SeanWei0312/ECG_Acquisition_IC/resources/Analog_Automation_gLayout/README.md

# gLayout Track Resources

- [Brief Overview of the gLayout](./files/Glayout_Overview.pdf)
- 🤖 [GitHub Repo](https://github.com/ReaLLMASIC/gLayout)
- :books: [gLayout Tutorials](https://github.com/ReaLLMASIC/gLayout/tree/main/tutorial)
  - [Flipped Voltage Follower (FVF)](https://github.com/ReaLLMASIC/gLayout/blob/main/tutorial/glayout_tutorial_FVF_part1.ipynb)
  - [Operational Transconductance Amplifier (OTA)]()
<!--
- :pushpin: Design Challenge
  - [Detailed Requirements](./Challenge.md)
  - [Kickoff Slides](https://docs.google.com/presentation/d/11iUuCnZQZhC-76pMEIqsWOjoYRWxP6tA/edit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)
  -->
- 🦾 [Contribution Guidelines]
  - [Fork the gLayout Repo]() 
  - [Contribute]()
  - [Create Merge Request]()

## gLayout

### A PDK-agnostic layout automation framework for analog circuit design.

gLayout is a powerful layout automation tool that generates DRC-clean circuit layouts for any technology implementing the gLayout framework. It is implemented as an easy-to-install Python package with all dependencies available on PyPI.

Key features:

- PDK-agnostic layout generation
  - Generic layer mapping
  - Technology-independent design rules
  - Support for multiple PDKs (sky130, gf180)
  - DRC-clean layout generation
- Basic Cell Generators
  - Via stack generation
  - Transistor generation (NMOS/PMOS)
  - Guard ring generation
  - And more...
- Natural language processing for circuit design
  - Convert natural language descriptions to layouts
  - Support for standard components
  - Custom component definitions
- Integration with Klayout for visualization and verification

## Citation

If you use gLayout in your research, please cite our papers:

```bibtex
@article{hammoud2024human,
  title={Human Language to Analog Layout Using gLayout Layout Automation Framework},
  author={Hammoud, A. and Goyal, C. and Pathen, S. and Dai, A. and Li, A. and Kielian, G. and Saligane, M.},
  journal={Accepted at MLCAD},
  year={2024}
}

@article{hammoud2024reinforcement,
  title={Reinforcement Learning-Enhanced Cloud-Based Open Source Analog Circuit Generator for Standard and Cryogenic Temperatures in 130-nm and 180-nm OpenPDKs},
  author={Hammoud, A. and Li, A. and Tripathi, A. and Tian, W. and Khandeparkar, H. and Wans, R. and Kielian, G. and Murmann, B. and Sylvester, D. and Saligane, M.},
  journal={Accepted at ICCAD},
  year={2024}
}
```
