SeanWei0312/ECG_Acquisition_IC/resources/C_MOSbius_playground_for_chips/cosimulation/README.md

# Cosimulation tutorial for Mixed-Signal simulations

This tutorial presents different views of a digital cell for running a co-simulation with an analog cell using gf180mcuD technology.

The goal is to perform a co-simulation between a 4-bit counter and the Verilog, Schematic, and PEX views with a current mirror that includes gf180mcu transistors. The current mirror is a schematic view.

The block diagram of the co-simulation system is presented below.

<p align="center">
   
</p>  

## Compiling and validating the Verilog code.

All the material associated with this part of the flow is in the [`verilog_verification/`](verilog_verification/) folder.

The command used for compiling is: **iverilog -o counter_tb counter.v counter_tb.v**

The command used for running the simulation is: **./counter_tb**

Finall, for checking the results, use the following command: **gtkwave counter_tb.vcd**

## Verilog view

Follows the block diagram of the circuit that instantiates a Verilog view into a symbol and the schematic of a current mirror.

<p align="center">
   
</p> 
 
When associating the Verilog code  to a symbol in Xschem, and after copiling the code for running the simulation with gf180mcu transistors, an error appears because the ngspice was compiled within the IIC-OSIC container for Chipathon. The two libraries that bridge the gap between ngspice and Icarus Verilog (ivlng.so and ivlng.vpi, both in /foss/tools/ngspice/lib/ngspice/) have all their symbols marked as local and should be as global.

<p align="center">
   
</p> 

We are working to solve this issue in the Docker container. We will keep you posted when this issue will be solved.

> 🚧 \*\*Under Construction\*\*

## Schematic view

All the material associated with this part of the flow is in the [`schematic_view/`](schematic_view/) folder.

First of all, it is necessary to run the RTL-to-GDS flow with Librelane, all the files are in the [`schematic_view/Librelane/`](schematic_view/) folder.

The command for running the Librelane Flow is: **librelane --pdk gf180mcuD config.json**

Once the flow ends, you can check all the files with all the reports associated with the different steps in the runs folder.

<p align="center">
   
</p> 

For opening the final layout, use the following command in the final/klayout_gds/ folder: **klayout -e counter.gds**

<p align="center">
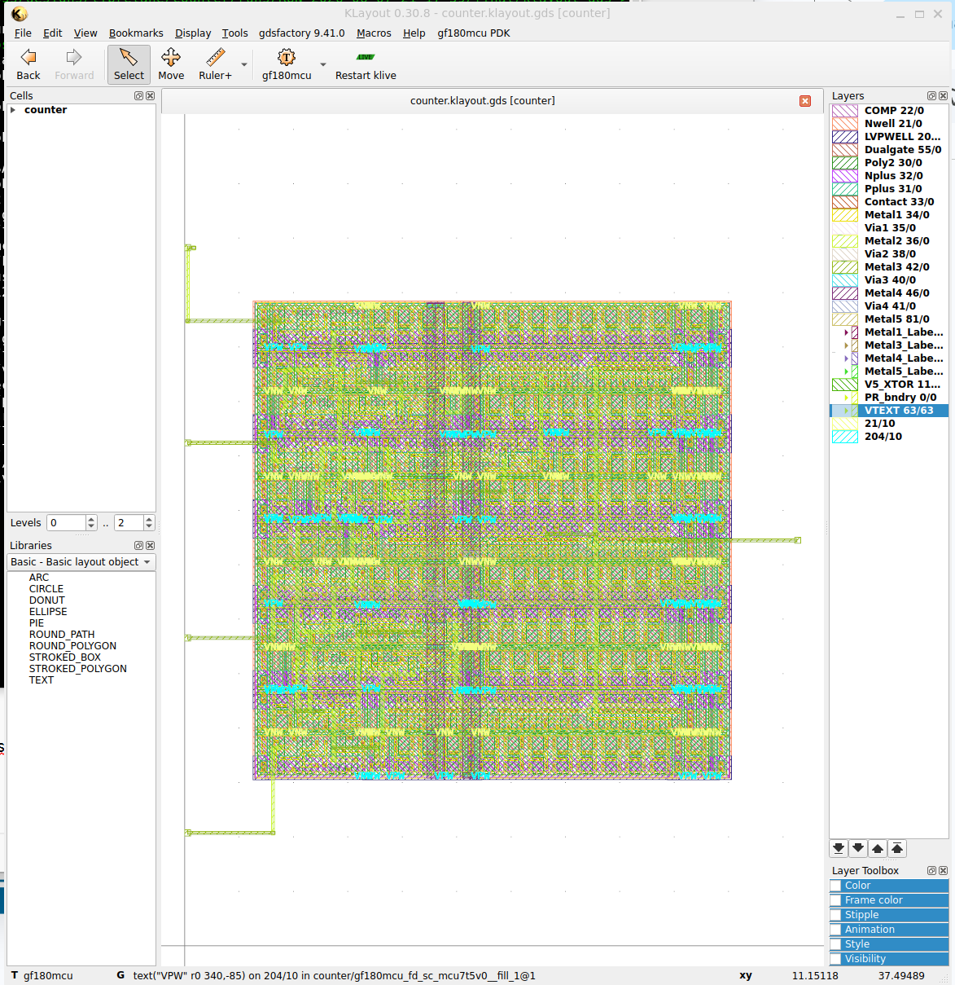
[picture p2: resources/C_MOSbius_playground_for_chips/cosimulation/img/klayout1.png]
   
</p> 

The file with the schematic netlist is in the **final/spice/** folder.

Copy the netlist file to the folder where you will run the cosimulation. In this repository, all the files are in [`schematic_view/cosimulation/`](schematic_view/) folder.

Some changes need to be made in the **counter.spice** file, as indicated in the figure below. Filler cells and decap cells need to be eliminated.

<p align="center">
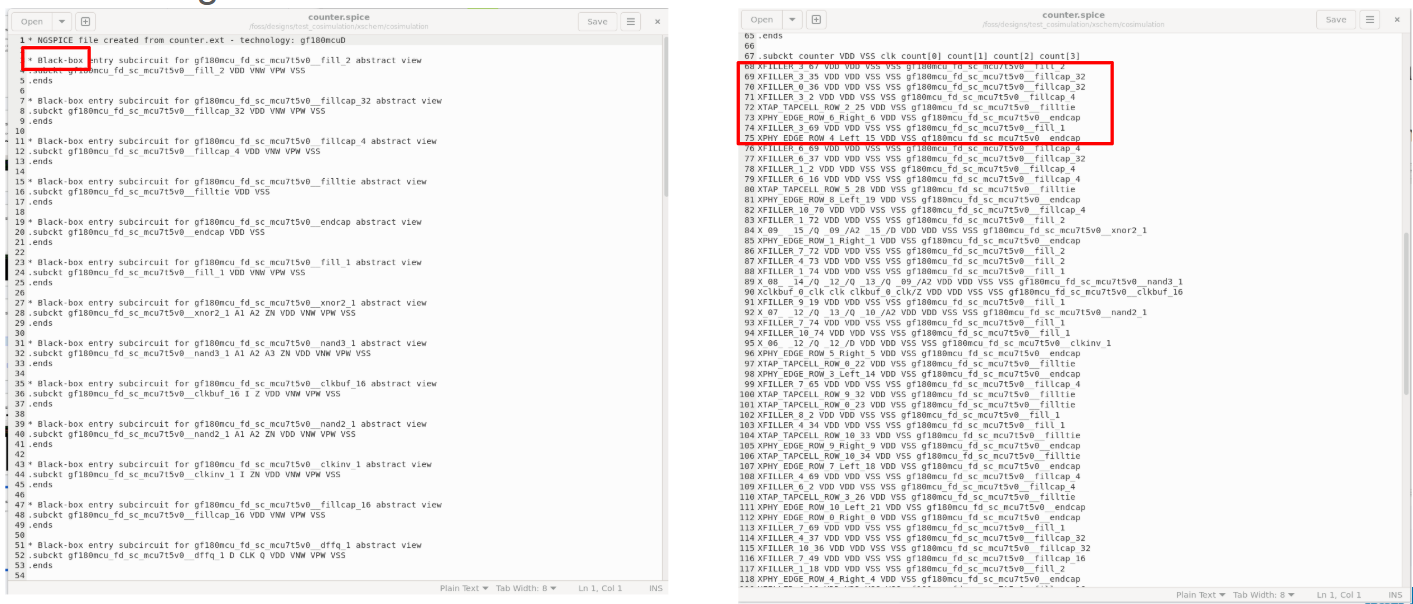
[picture p3: resources/C_MOSbius_playground_for_chips/cosimulation/img/cosimulation1.png]
   
</p> 

The sequence to run the simulations in the following:

1) In the **Simulation** tab, select the **Use 'simulation' dir in schematic dir** option.
2) Click on the **Netlist** button.
3) Click on the **Simulation** button.
4) Once the simulation ended, close the ngspice window. Then **'Ctrl' + left click button of the mouse** on the **load waves** symbol. It should take a couple of seconds loading the 
waveforms, as indicated in the figure below.

<p align="center">
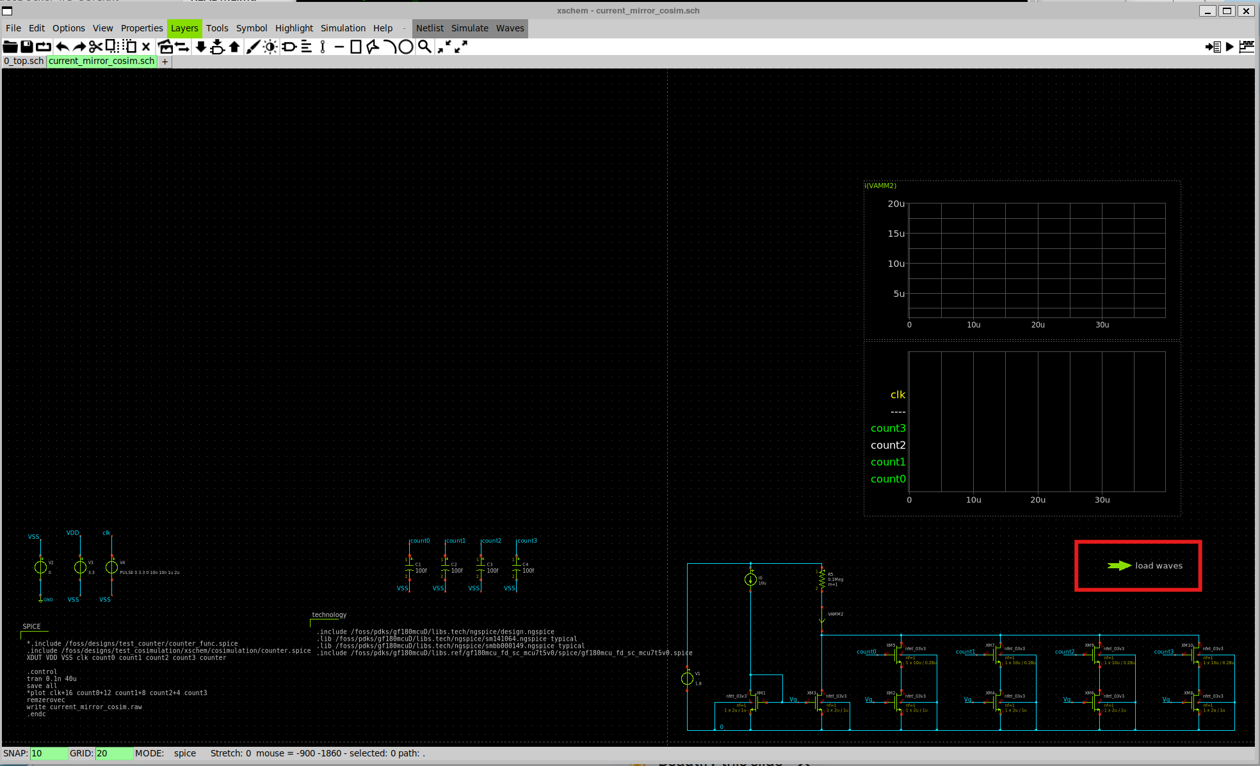
[picture p4: resources/C_MOSbius_playground_for_chips/cosimulation/img/cosimulation2.png]
   
</p> 

<p align="center">
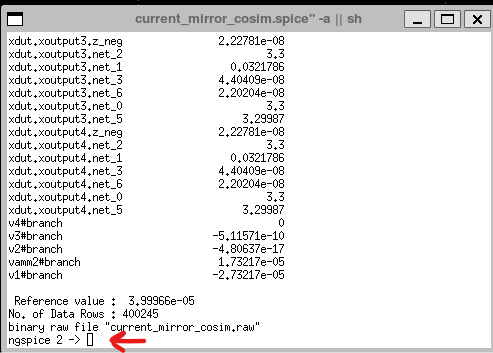
[picture p5: resources/C_MOSbius_playground_for_chips/cosimulation/img/cosimulation3.png]
   
</p> 

<p align="center">
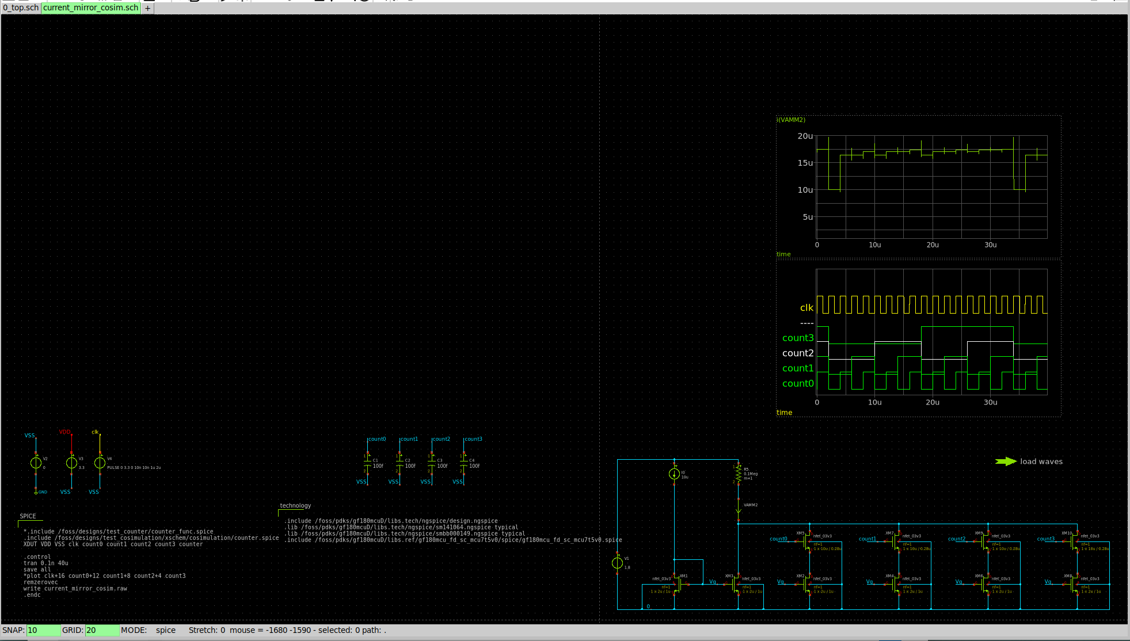
[picture p6: resources/C_MOSbius_playground_for_chips/cosimulation/img/cosimulation4.png]
   
</p> 

## PEX view
