SeanWei0312/ECG_Acquisition_IC/ECG Acquisition IC with 10-bit SAR ADC SPEC.xlsx

Spec | Data | Improve | Spec | Data | Improve | Spec | Data | Improve | Spec | Data | Improve | Spec | Data | Improve | Spec | Data | Improve
AVDD | 3.3 V | fixed | AVDD | 3.3V | fixed | AVDD | 3.3 V | fixed | AVDD | 3.3 V | fixed | AVDD | 3.3 V | fixed | Input voltage | 5 V | fixed
 |  |  | VCM | 1.65 V | fixed | VCM | 1.65 V | fixed | VCM | 1.65 V | fixed | DVDD | 3.3 V | fixed | Output voltage | 3.3 V | fixed
 |  |  | CMRR target | 90 dB | higher | HPF cutoff | 0.01 Hz | fixed | Gain control | 2 bit | higher | VCM | 1.65 V | fixed | AVDD | 3.3 V | fixed
 |  |  | Total gain | 90 V/V (39.08 dB) | fixed | LPF cutoff | 150 Hz | fixed | Gain setting 1 | 4 V/V | fixed | VREFP |  | fixed | DVDD | 3.3 V | fixed
 |  |  | 1st-stage gain | 10 V/V | fixed | Passband | 0.01–150 Hz | fixed | Gain setting 2 | 8 V/V | fixed | VREFN |  | fixed | Dropout | <300 mV | lower
 |  |  | 2nd-stage gain | 9 V/V | fixed | Stopband attenuation | 60 dB | higher | Gain setting 3 | 12 V/V | fixed | Resolution | 10 bit | fixed | PSRR @ 50/60 Hz | >60 dB | higher
 |  |  | OTA DC gain | 80 dB | higher |  |  |  | Gain setting 4 | 16 V/V | fixed | Sample rate | 10 kS/s | fixed
 |  |  | Single-ended OTA PM | 60° | higher |  |  |  | Total gain min | 360 V/V | fixed | Work clock | 320 kHz | fixed
 |  |  | Fully differential OTA PM | 60° | higher |  |  |  | Total gain max | 1440 V/V | fixed | ENOB |  | higher
 |  |  | Single-ended OTA bias | 40 µA | lower |  |  |  |  |  |  | INL |  | lower
 |  |  | Fully differential OTA bias | 50 µA | lower |  |  |  |  |  |  | DNL |  | lower
 |  |  | CMFB error amp bias | 50 µA | lower
