SeanWei0312/ECG_Acquisition_IC/schedule/README.md

# SSCS Chipathon 2026 Schedule

This document outlines the official schedule for the SSCS Chipathon 2026 event.
<br>All dates and activities are subject to confirmation.
<br>This is the 8am PT [weekly zoom meeting link](https://us06web.zoom.us/j/87694732928?pwd=gjUePaAEKDJB2G3f2d4iPIqyYe0qBx.1).
<br>Please follow the Chipathon Discord Server [Join_server](https://discord.gg/tvZcQzvt7q) for up-to-date information and **announcements**. 
<br>All participants should complete a report by Wednesday of **each** week.

## 🗓️ Detailed Timeline

### Phase 1: Setup and Introduction
| Week | Date | Event | Track Details | 🔴 Recording | 📊 Slides | 📄 Report |
|---|---|---|---|:---:|:---:|:---:|
| Week 19 | May 8 | **Kick-off Meeting** 🎓 | • Explain the different phases of Chipathon (Mehdi Saligane) | [Watch](https://us06web.zoom.us/rec/share/xhAeTdAPaU77YRsU4t_Q-E41hRicV-ab5xPvtx_s73yeb8BakzFSihVeXmSdaLQF.pho0MkNOSw_0mVMb) | [View](https://docs.google.com/presentation/d/e/2PACX-1vS0FR0zXk5OT03u0vTPz__WF2TcbxiVppoEyPhbsLTgC3EPxX-VpvyrcpCeCY_emw/pub) | closed |
| Week 20 | May 15 | **Tool Installation** 🎓 | • Tutorial on xschem in GF from schematic to Layout & Spice Simulation (Saroj) <br> • Librelane Tutorial (Mauricio) <br> • DRC/LVS (Mitch) | [Watch](https://us06web.zoom.us/rec/share/7zD5YMcYuP_7zsn03mudSRr1iZ_iZvFGw_r3zQALDaS0kD1FwE4AAih6qV63WzpB.rxw93Cc6FIBtpyRp) | [View](https://docs.google.com/presentation/d/e/2PACX-1vSFLC4CtHCYh4NrQxUPHT01zM8Mj39ZOmFqZuFMlWBCxX44cPWaUJRWhY8hl38a_Q/pub) | closed |
| Week 21 | May 22 | **Tutorial Sessions** 🎓 | • MOSbius Overview (Andrew Chon)<br>• gLayout [Tutorial 1 FVF](https://github.com/ReaLLMASIC/gLayout/blob/main/tutorial/glayout_tutorial_FVF_part1.ipynb) (Luighi) | [Watch](https://us06web.zoom.us/rec/share/i6gGItWpTriycR9Vz1Rcwi5HxPswXAdAXv9iy_UUyQIKtjeq1cgjDXfQwc3FVlXj.y_eDORm6bc2WuAs-) | [View](https://docs.google.com/presentation/d/e/2PACX-1vSMgWGc4wd2y3oCXPovcalyahoOMKKFyx0ZqtsaBfOtss39HV3pLOSkca_K4jcmtg/pub) | closed |
| Week 22 | May 29 | **Tutorial Sessions** 🎓 | • Charlib (James)<br>• Full custom analog design flow (Vipul)<br> • ORFS Tutorial (Gaurav) <br>• gLayout [Tutorial 2 OTA]() (Anhang) | [Watch](https://us06web.zoom.us/rec/share/MLNBCb7vB8ggzrkPwc0yAslUJFi819PqMK6GzwiTdWhMRykd2PMECP5OVaj9fJtg.FKPz8puBRcpvN9k1) | [View](https://docs.google.com/presentation/d/e/2PACX-1vQTP6VWPEWemqOwfaWyAoGDvfKKkSd3Na3WMATTWCTAIPIPWx0YFB2lkzolOIVV8w/pub) | closed |

### Phase 2: Team Formation and Project Planning
| Week | Date | Event | Details | 🔴 Recording | 📊 Slides | 📄 Report |
|---|---|---|---|:---:|:---:|:---:|
| Week 23 | June 5 | **Team Formation Deadline**| • Chip design with AI/LLM (Mehdi) <br>• Hands-on Tutorial on MOSbius (Juan)| [Watch]( https://us06web.zoom.us/rec/share/lz8rKOhmYU-1TsQuje8IZh32oWiNp8pjVdyQ4QdtBKiGaN21z6OqeIRHgq0hYxV8.zMbz-0kW_5zsKOk8) | [View](https://docs.google.com/presentation/d/e/2PACX-1vQI_AdDKBr6G66_IMallotI_idrNMwKabdypLI7G8iEzwwMeTTeQIN3yLcrxRuJxQ/pub) | closed |
| Week 24 | June 12 | **Project Proposal Review** 👥 | - | [Watch A01-A35](https://drive.google.com/file/d/1L1Z3aQcKbWLOrGrg6Hj4yo3hvyqHSkSH/view?usp=drive_link) <br>[Watch A36-A70](https://drive.google.com/file/d/1zNI8uM8IrhVsJ0CvSOXPGysJ70YsLTbz/view?usp=drive_link) <br> [Watch B01-B30](https://drive.google.com/file/d/186RtQrj5eBq5YQaNelR__m42KvpKolv7/view?usp=drive_link) <br> [Watch C01-D16](https://drive.google.com/file/d/1WcvnuNNZa5OvVjBBpA2cFpxIVmz5NF8p/view?usp=drive_link)| [View A01-A35](https://docs.google.com/presentation/d/1YiHz-10-ayeriHM-xqGJkT-SbB14Z78Zl8ZGlZeix68/edit?usp=sharing)  <br>[View A36-A70](https://docs.google.com/presentation/d/1hOIqOPzlGIcLJ2AFiHNvrpxC8wyUOxMAJF15Aqmjsis/edit?usp=sharing) <br> [View B01-B30](https://docs.google.com/presentation/d/1q4hdv7IWDyOom2BOauEokjyfa9oZNoGCGBChGqaYRIs/edit?usp=sharing) <br> [View C01-D16](https://docs.google.com/presentation/d/1fg-tLoPCH4SCN_3tkq7wYo87EJUDZR3OUUjlz6IXLH8/edit?usp=sharing)| closed |
| Week 25 | June 19 | **Advanced Topics** 🎓 | • Systematic Design of Analog CMOS Circuits (Boris) | [Watch](https://us06web.zoom.us/rec/share/3vk6f6Bt4MRCwtoFo-XEr-KmHi765R8c8R6uieeFrG9smnGP3wtC_eQlbBFLzGra.8AWW7h7pANInL2vD) | [View](https://docs.google.com/presentation/d/e/2PACX-1vQskh77zL1A6RuCtjrjYBFjEMV9KKKAnJLeW1QzCBsPwpewTReR5-Y35LPDksaUCA/pub)| closed |
| Week 26 | June 26 | **Analog Design Ideas** 🎓 | • Overview of MEMS sensors (Camilo) <br>• Introduction to CACE (Leo)| [Watch](https://us06web.zoom.us/rec/share/F5SoZ1tjJ3ukiBgUIBTINPDOeT-OkPaO-5CeIl7zW6LeFi0y_aNfPbf5_4uGC8Wb.u2S9Jk62cXnbVsac) | [View](https://docs.google.com/presentation/d/e/2PACX-1vTqOtDIIBs6RNZgejP_mli8eXTi4CajlAEZ0-tehu2-FIgI78x62veDrAMgh-xYEQ/pub) | [Submit](https://forms.gle/6839F1Jppxx42yw5A) |

### Phase 3: Design and Simulation
| Week | Date | Event | Review Focus | 🔴 Recording | 📊 Slides | 📄 Report |
|---|---|---|---|:---:|:---:|:---:|
| Week 27 | July 3 | **Analog Design Ideas** 👥  | • Tutorial: Schematic Database & Simulations (Peter)<br>• Analog devices for RF applications (Sadayuki) |  |  |  |
| Week 28 | July 10 | **Simulation Review ** 👥 | All Tracks |  |  |  |
| Week 29 | July 17 | **Simulation Review ** 👥 | - |  |  |  |
|  | | **READiness Check & Go/No-go Decision** |  |  |  |  |

### Phase 4: Layout and Verification
| Week | Date | Event | Details | 🔴 Recording | 📊 Slides | 📄 Report |
|---|---|---|---|:---:|:---:|:---:|
| Week 30 | July 24 | **Layout Tutorial** 🎓 | • DRC, LVS, PEX (Mitch, Juan) <br> (tentative) |  |  |  |
| Week 31 | July 31 | **DRC Dry-run** | GDS to Channel Partner |  |  |  |  |
| Week 32 | Aug. 7 | **Integration Tutorial** 🎓 | Layout, Top level, ESD, padframe, packaging (Tim, Juan) |  |  |  |
| Week 33 | Aug. 14 | **Layout Review (blocks)** 👥 | - |  |  |  |
| Week 34 | Aug. 21 | **Layout Review (top level)** 👥 | - |  |  |  |
|  | | **DRC Dry-run GDS to Channel Partner**  | |  |  |  |
| Week 35 | Aug. 28 | **Verification** 👥 | Secondary ESD (Juan/Luighi) |  |  |  |
|  | | **Final Chip Review** 👥 | - |  |  |  |
|  | TBD | **Final Submission** | DRC-clean GDS to Channel Partner |  |  |  |  |
|  | TBD | **Post-mortem** 👥 | Project retrospective |  |  |  |

### Phase 5: Manufacturing and Testing
| Date | Event | 🔴 Recording | 📊 Slides | 📄 Report |
|---|---|:---:|:---:|:---:|
| TBD | Chips available for testing |  |  |  |  |
| TBD | Upload of Chip Test Results 👥 |  |  |  |  |

## 📋 Track Overview

The chipathon includes several parallel tracks:
- **A. Foundational building blocks**: Focused on basic analog and digital blocks.
- **B. Circuits for sensors**: Focused on circuits and systems enabling sensing, readout, and edge signal processing.
- **C. MOSbius playground for chips**: Focused on educational chips MOSbius style.
- **D. AI/LLM for circuits**: Focused on automated design flows (analog or digital) powered by AI.

## 🎯 Legend
- 🎓 **Presentations by mentors**: Technical sessions and tutorials
- 👥 **Presentations by participants**: Reviews and demonstrations
- 📼 **Recordings**: Links to session recordings (TBA = To Be Added)

## ⚠️ Important Notes

- All dates are subject to change
- Participants should complete installations and review materials before their respective sessions
- Regular attendance in tutorial sessions is highly recommended
- Teams must meet all review deadlines to proceed to the next phase
- The go/no-go decision on (TBD) is a critical milestone for proceeding with manufacturing
- All sessions will be recorded and made available after each meeting

## 📞 Support

For questions about specific issues, please contact the respective leaders:
- A. Foundational building blocks: James Stine, Saroj, Gaurav, Akhilesh Patil, Sumanth Kamineni
- B. Circuits for sensors: Camilo Velez, Vipul Sharma
- C. MOSbius playground for chips: Peter Kinget, Juan Moya Baquero, Luighi
- D. AI/LLM for circuits: Luighi, Mehdi Saligane, Saptarshi Ghosh, Gaurav, Osama Khan, Trio Adiono/Nur, Mauricio Montanares
- Tooling: Mitch, Harald, Leo, Saroj, Mehdi, Peter, Vipul, Herman, Luighi
- Integration: Juan M. Baquero
- Logistics: John, Indira, Mitch
