SeanWei0312/ECG_Acquisition_IC/Design_Files/IC Design/Schematic/AFE_BLOCKS/MIRROR/MIRROR.png

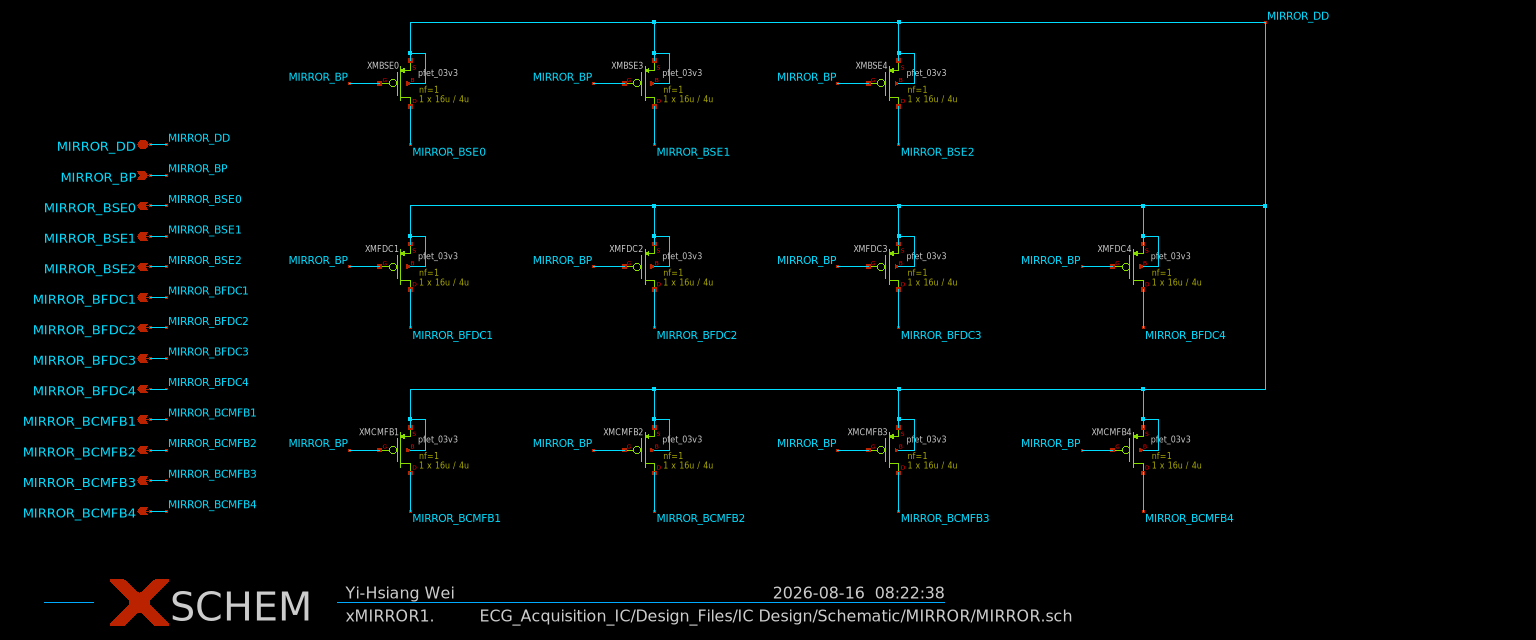
Design_Files/IC Design/Schematic/AFE_BLOCKS/MIRROR/MIRROR.png
