SeanWei0312/ECG_Acquisition_IC/Measurement_Results/IC_Simulation/AFE_BLOCKS/BIAS/BIAS_startup_summary.csv

Parameter | Value | Unit | Process | Condition | Temp_C | VDD_V | Total
Worst startup time | 1180.281 | us | SS | TLVL | -40.000 | 3.000
Startup failures | 0 | count |  |  |  |  | 35
