SeanWei0312/ECG_Acquisition_IC/Measurement_Results/IC_Simulation/ANALOG_BLOCKS/FDOTA/CMFB/NOM.CMFB_summary.csv

Parameter | Unit | Value
Set conditions
AVDD | V | 3.3
Bias current | uA | 40
CLoad per output | pF | 10
Vin,diff | V | 0
VCMFB,REF | V | 1.65
Vout,cm target | V | 1.65
Operating
Total current | uA | 39.8238
Total power | mW | 0.131418
VCMFB,OUT | V | 2.4832
VCMFB,IN | V | 1.64994
VCMFB,OUT target | V | 2.4832
Open-loop
DC gain | dB | 45.1371
UGF | MHz | 967.213
PM | deg | 71.9003
Closed-loop
VCMFB,OUT err | mV | -0.00011719
VCMFB,IN err | mV | -0.0585949
Valid VCMFB,REF | V | 1.05-3.01
tsettle low | ns | 5.2
tsettle high | ns | 5.2
