SeanWei0312/ECG_Acquisition_IC/Measurement_Results/IC_Simulation/ANALOG_BLOCKS/FDOTA/Results/FULL_FDOTA_MC_Summary.csv

Parameter | Unit | Spec | Min | MeanMinus3Sigma | MeanMinusSigma | Mean | MeanPlusSigma | MeanPlus3Sigma | Max | Yield_pct
FDC bias current | uA | 40±10 | 38.7426 | 38.1954400411523 | 39.4657226803841 | 40.100864 | 40.7360053196159 | 42.0062879588477 | 41.7383 | 100
CMFB bias current | uA | 40±10 | 38.7322 | 38.2207218172121 | 39.4793056057374 | 40.1085975 | 40.7378893942627 | 41.996473182788 | 41.627 | 100
Total current | mA | ≤2.5 | 1.51992 | 1.49782080434806 | 1.57035383478269 | 1.60662035 | 1.64288686521731 | 1.71541989565194 | 1.74577 | 100
Total power | mW |  | 5.01572 | 4.94281179403299 | 5.18216883134433 | 5.30184735 | 5.42152586865567 | 5.66088290596701 | 5.76104 | NaN
Differential DC gain | dB | ≥85 | 91.1431 | 90.9713651848174 | 91.6781257282724 | 92.031506 | 92.3848862717275 | 93.0916468151826 | 93.0003 | 100
Differential UGF | MHz | ≥8 | 12.8589 | 12.6610961624769 | 13.9721143874923 | 14.6276235 | 15.2831326125077 | 16.5941508375231 | 16.8425 | 100
Differential phase margin | deg | ≥60 | 73.4026 | 72.9781425439753 | 75.7096765146584 | 77.0754435 | 78.4412104853416 | 81.1727444560247 | 80.5429 | 100
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
