SeanWei0312/ECG_Acquisition_IC/Measurement_Results/IC_Simulation/ANALOG_BLOCKS/FDOTA/Results/MM_FDOTA_MC_Summary.csv

Parameter | Unit | Spec | Min | MeanMinus3Sigma | MeanMinusSigma | Mean | MeanPlusSigma | MeanPlus3Sigma | Max | Yield_pct
FDC bias current | uA | 40±10 | 38.8722 | 38.4336959842166 | 39.5351519947389 | 40.08588 | 40.6366080052611 | 41.7380640157834 | 41.518 | 100
CMFB bias current | uA | 40±10 | 38.9268 | 38.4586851912279 | 39.5486367304093 | 40.0936125 | 40.6385882695907 | 41.728539808772 | 41.5456 | 100
Total current | mA | ≤2.5 | 1.54166 | 1.52528877524591 | 1.57761509174864 | 1.60377825 | 1.62994140825136 | 1.68226772475409 | 1.68284 | 100
Total power | mW |  | 5.08749 | 5.03345398922018 | 5.20612982974006 | 5.29246775 | 5.37880567025994 | 5.55148151077982 | 5.55336 | NaN
Differential DC gain | dB | ≥85 | 92.0457 | 92.0503053875104 | 92.0596107958368 | 92.0642635 | 92.0689162041632 | 92.0782216124896 | 92.0742 | 100
Differential UGF | MHz | ≥8 | 13.8096 | 13.6255065444044 | 14.2630621814681 | 14.58184 | 14.9006178185319 | 15.5381734555956 | 15.8248 | 100
Differential phase margin | deg | ≥60 | 76.4466 | 76.5202623512142 | 76.9214434504047 | 77.122034 | 77.3226245495953 | 77.7238056487858 | 77.6478 | 100
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
