SeanWei0312/ECG_Acquisition_IC/Measurement_Results/IC_Simulation/ANALOG_BLOCKS/FDOTA/Results/FDOTA_MC_Run_Summary.csv

Mode | RequestedRuns | ValidRuns | FailedRuns | OverallYield_pct
MM | 200 | 200 | 0 | 100
GL | 200 | 200 | 0 | 100
FULL | 200 | 200 | 0 | 100
