SeanWei0312/ECG_Acquisition_IC/Measurement_Results/IC_Simulation/ANALOG_BLOCKS/FDOTA/Results/GL_FDOTA_MC_Summary.csv

Parameter | Unit | Spec | Min | MeanMinus3Sigma | MeanMinusSigma | Mean | MeanPlusSigma | MeanPlus3Sigma | Max | Yield_pct
FDC bias current | uA | 40±10 | 39.2727 | 39.1210362629115 | 39.7919970876372 | 40.1274775 | 40.4629579123629 | 41.1339187370885 | 40.9503 | 100
CMFB bias current | uA | 40±10 | 39.2727 | 39.1210362629115 | 39.7919970876372 | 40.1274775 | 40.4629579123629 | 41.1339187370885 | 40.9503 | 100
Total current | mA | ≤2.5 | 1.54822 | 1.53464318469886 | 1.58330886156629 | 1.6076417 | 1.63197453843371 | 1.68064021530114 | 1.68094 | 100
Total power | mW |  | 5.10913 | 5.06432604194118 | 5.22492018064706 | 5.30521725 | 5.38551431935294 | 5.54610845805882 | 5.54711 | NaN
Differential DC gain | dB | ≥85 | 91.1432 | 90.972535795399 | 91.6783885984663 | 92.031315 | 92.3842414015336 | 93.090094204601 | 92.9965 | 100
Differential UGF | MHz | ≥8 | 13.0821 | 12.7801082126749 | 14.0168657375583 | 14.6352445 | 15.2536232624417 | 16.4903807873251 | 16.2653 | 100
Differential phase margin | deg | ≥60 | 73.5783 | 73.0423383789955 | 75.7334647929985 | 77.079028 | 78.4245912070015 | 81.1157176210045 | 80.6022 | 100
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
