SeanWei0312/ECG_Acquisition_IC/Measurement_Results/IC_Simulation/AFE_BLOCKS/AFE/Plots/AFE_selector_routing.png

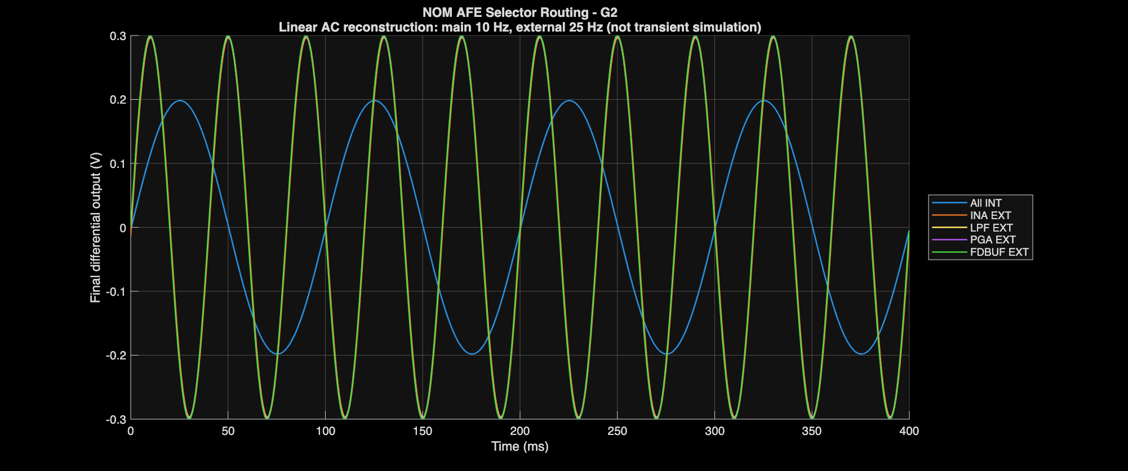
Measurement_Results/IC_Simulation/AFE_BLOCKS/AFE/Plots/AFE_selector_routing.png
