SeanWei0312/ECG_Acquisition_IC/Measurement_Results/IC_Simulation/ANALOG_BLOCKS/FDOTA/CMFB/Plots/cl_dc.png

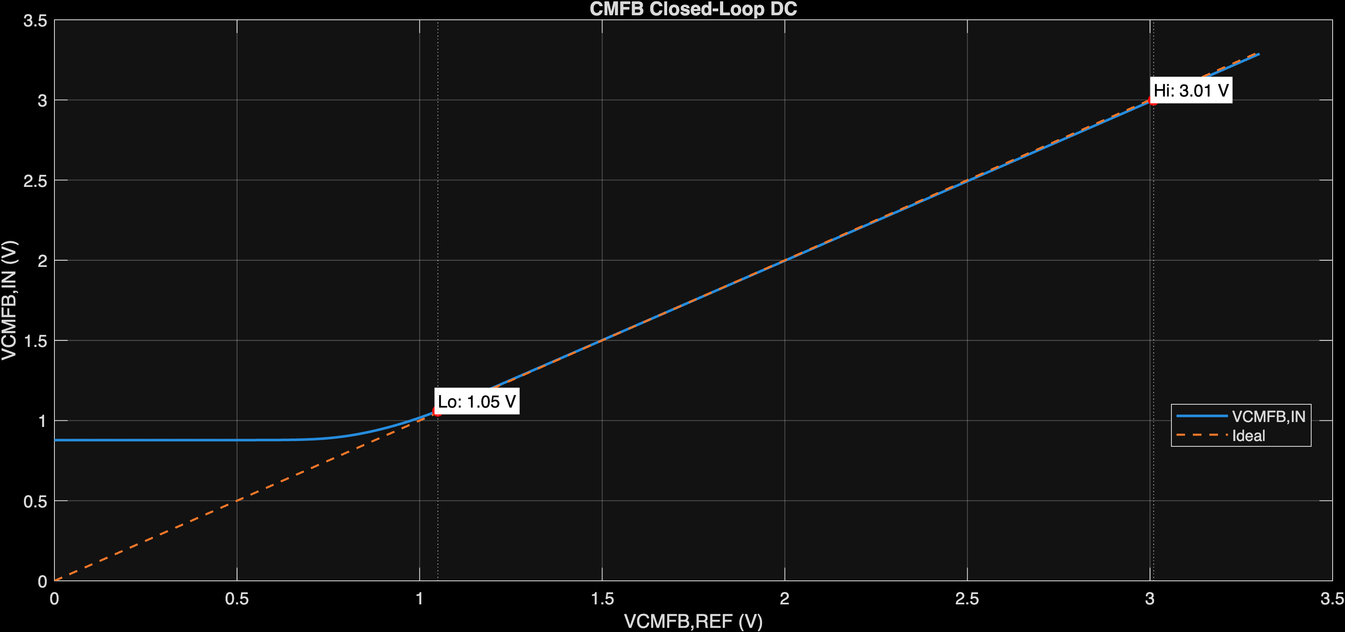
Measurement_Results/IC_Simulation/ANALOG_BLOCKS/FDOTA/CMFB/Plots/cl_dc.png
