SeanWei0312/ECG_Acquisition_IC/Measurement_Results/IC_Simulation/ANALOG_BLOCKS/FDOTA/CMFB/Plots/ol_ac.png

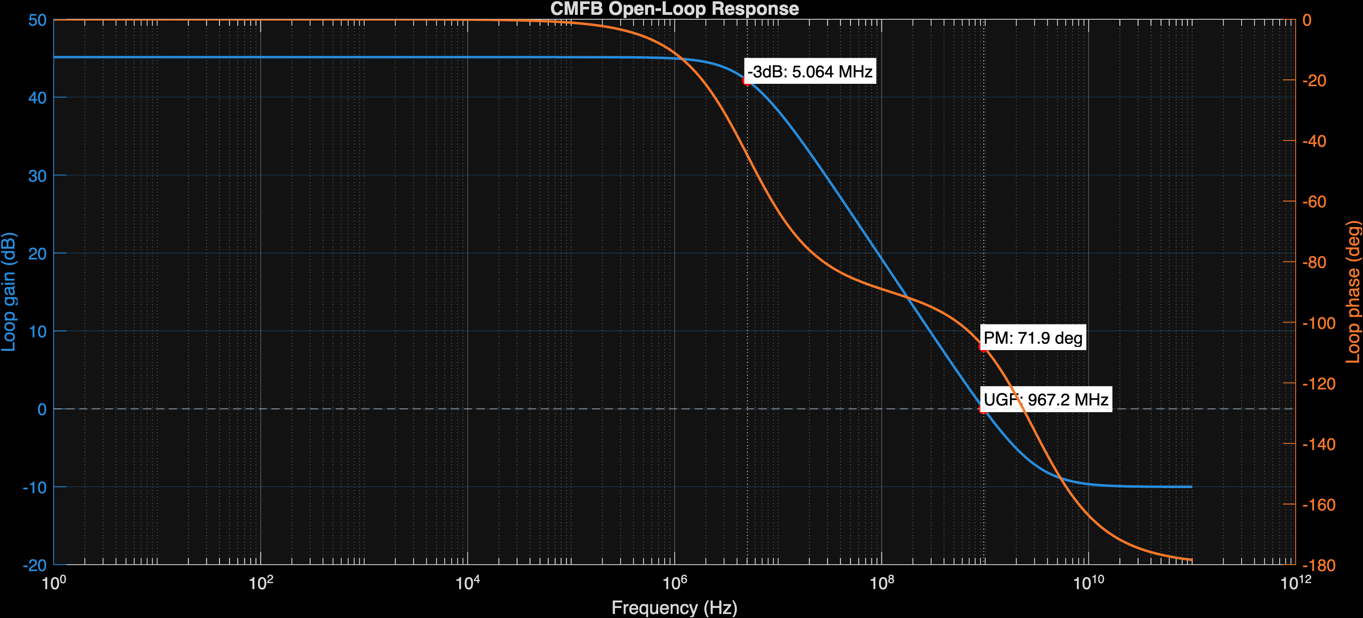
Measurement_Results/IC_Simulation/ANALOG_BLOCKS/FDOTA/CMFB/Plots/ol_ac.png
