SeanWei0312/ECG_Acquisition_IC/(commit log)

2026-05-12 added documentation for analog design are resources\/Analog
    [TB_inv1.sch, inv1.sch]
2026-06-07 schematic cosimulation files uploaded
    [current_mirror_cosim.sch, pin_order.cfg]
2026-07-03 add sscs-chipathon-2026
    [TB_inv1.sch, asig5V_AC_tb.sch, asig5V_DC_tb.sch, asig5V_tran_tb.sch, bi_t_tran_tb.sch, current_mirror_cosim.sch, dvdd_AC_tb.sch, inv.sch]
2026-07-05 update Design Files
    [inv_tb.sch]
2026-08-08 Update project files and Docker instructions
    [AFE_TB_AC.sch, AFE_TB_NOISE_NOM.sch, AFE_TB_TRAN.sch, AFE_summary.csv, BUFFER.sch, CLK2P.sch, CMFB.sch, CMFB_TB_CL_NOM.sch]
2026-08-15 Ignore simulation TXT files
    [NOM.cl_diff_dc.txt, NOM.cl_diff_tran.txt, NOM.diff_ac.txt, NOM.ol_diff_ac.txt]
2026-08-15 Update upstream Chipathon files
    [inv_tb.sch]
2026-08-19 update 8/18
    [AFE.sch, INA_RLD_TB_NOM.sch]
2026-09-21 Update AFE designs and verification
    [AFE.sch, BUFFER.sch, BUFFER_TB_FF.sch, BUFFER_TB_FS.sch, BUFFER_TB_MM.sch, BUFFER_TB_NOM.sch, BUFFER_TB_SF.sch, BUFFER_TB_SS.sch]
2026-09-21 Keep SAR ADC files local only
    [BSW.sch, CDAC.sch, CLK_GEN.sch, COMP.sch, DLY_CELL.sch, INV.sch, INV2.sch, MUX.sch]
